bigtreetech/BIGTREETECH-MAX31865/BIGTREETECH MAX31865 V2.0/Hardware/BIGTREETECH MAX31865 V2.0-PIN.pdf

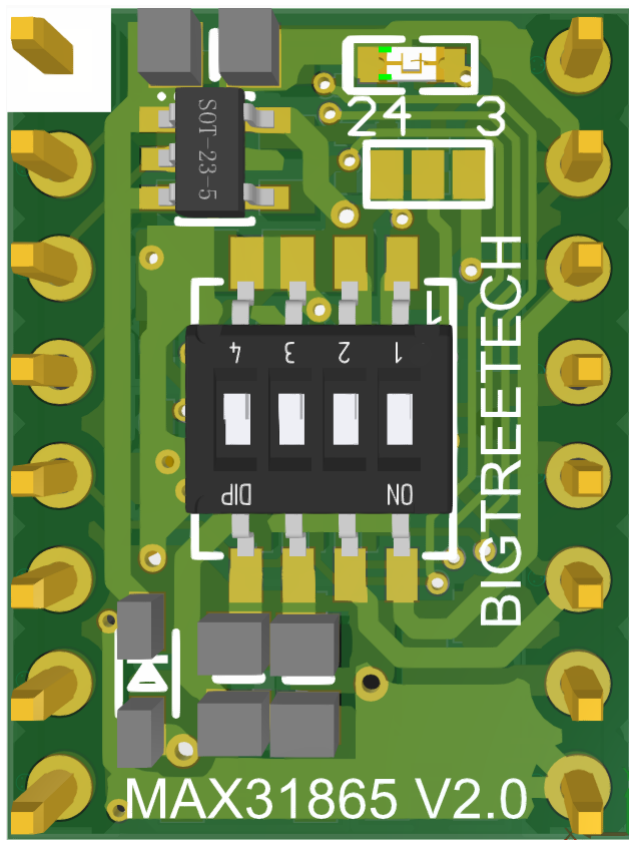
[picture p11: figure]

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
FORCE+

RTDIN+

RTDIN

NC

FORCE

NC

NC
