bigtreetech/BIGTREETECH-MAX31865/BIGTREETECH MAX31865 V1.0/3D/BTT MAX31865 V1.0.step

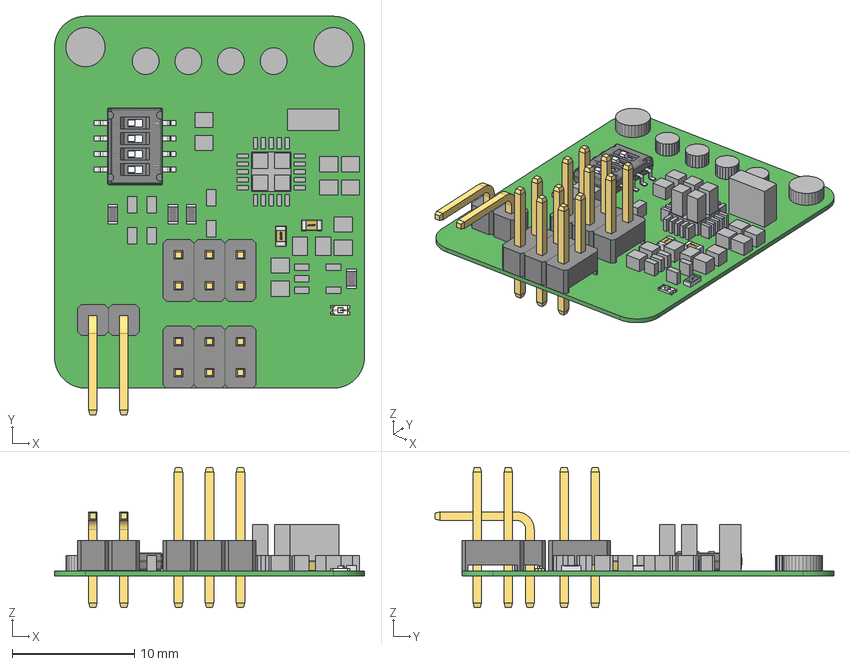
[picture p12: CAD file, 2021-06-21, an earlier design]
BIGTREETECH MAX31865 V1.0/3D/BTT MAX31865 V1.0.step
25.4 x 32.7 x 11.5 mm
R0603 x 4
Open_CASCADE_STEP_translator_6.8_20.1
Open_CASCADE_STEP_translator_6.8_20.2.1
Leader x 8
LOGO? x 9
LED_0603-W
Extruded x 58
HDR2.54-1x2P x 6
HDR2.54-1P_H x 2
