bigtreetech/BIGTREETECH-MAX31865/EZ31865_V1.0/Hardware/BIGTREETECH EZ31865 V1.0 Manual.pdf

BIGTREETECH EZ31865 V1.0 USER MANUAL | Shenzhen Biqu Technology Limited Company
Shenzhen Biqu Technology | 1 / 11 | URL:www.BIGTREE-TECH.com

SHENZHEN BIQU TECHNOLOGY LIMITED COMPANY BIGTREETECH

# BIGTREETECH

# EZ31865 V1.0

# USER MANUAL

【Please read this manual carefully before use】

BIGTREETECH MAX31865 V2.0 USER MANUAL Shenzhen Biqu Technology Limited company

2 / 11

# CONTENTS

BIGTREETECH motherboard and BIGTREETECH EZ31865 V1.0 module connection

3 / 11

## Revision History

Version | Revisions | Date
01.00 | Original | 2022/11/08


4 / 11

# BIGTREETECH MAX31865 V2.0 Module

## Introduction

This module uses MAX31865 chip, supports two-wire, three-wire,

four-wire PT1000 and PT100 temperature sensors, adopts the same

package of motor drive module, easy to install, and uses VCCIO part of

the power supply. Support 3.3V-5V power input.

## 1.Pin Introduction

VIO—Positive power supply (3.3V-5V)

GND—Power negative

MO--data input

MI--Data output

SCK--Clock line

CS--Chip Select


5 / 11

## 2.DIP Switch Configuration

1 | 2 | 3 | 4 | Sensor Model
ON | ON | ON | OFF | Two lines PT100
ON | ON | OFF | ON | Two linesPT1000
OFF | ON | ON | OFF | Three lines PT100
OFF | ON | OFF | ON | Three lines PT1000
OFF | OFF | ON | OFF | Four-wire PT100
OFF | OFF | OFF | ON | Four-wire PT1000

The 2/4 line is shown in the left figure. If the 3 line is used, it needs to be changed to the right figure (the factory default is 2/4 line)

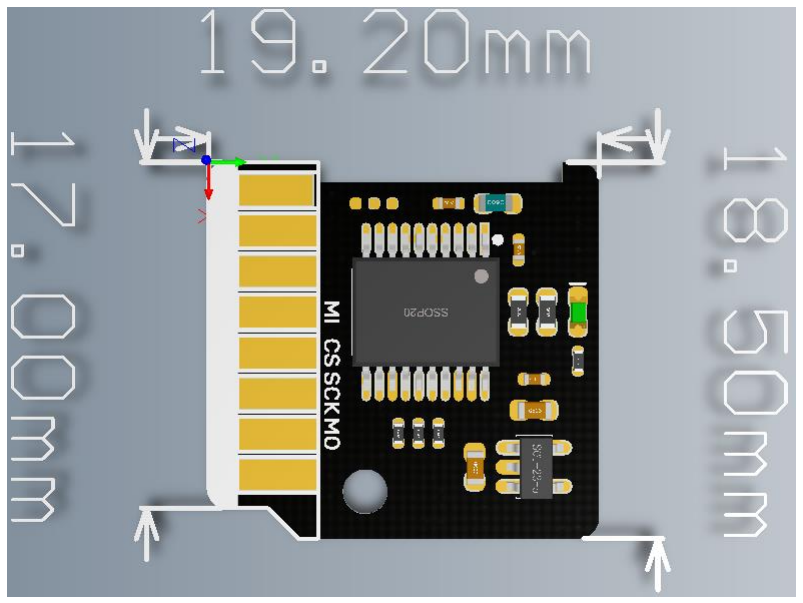
[picture p13: figure]

6 / 11

3 wires can also use 2 wires, but the accuracy is slightly reduced (same as 2 wires).

## 3.Connection of Module Installation Method

The installation method is consistent with EZ series drive
Modify the program of the motherboard, select the SPI mode of the motherboard driver jumper, and directly connect BIGTREETECH MAX31865V2.0 to the idle motor driver of the motherboard, and then connect the PT100/PT1000 thermistor to the corresponding original motor line On the interface (need to pay attention to the line sequence, subject to the actual motherboard, only support the motherboard that supports the SPI mode pluggable drive).

# Installation Size:

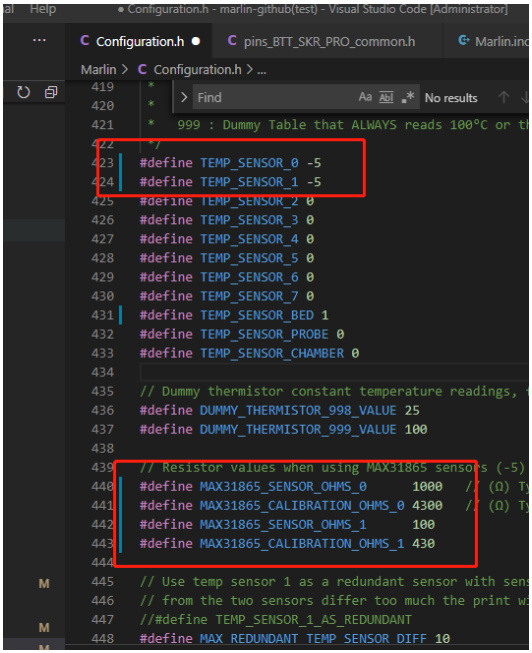
[picture p14: figure]

7 / 11

# Marlin firmware configuration:

Marlin firmware supports the connection of up to two BTT PT1000&PT100 modules. The default is two-wire and four-wire common, through the configuration of Configuration.h and Configuration_adv.h files. The BTT PT1000&PT100 module can be a PT100 or PT1000 sensor, and different parameters need to be configured.

## 1,Configuration in Configuration.h:

TEMP_SENSOR_0 Set to -5: Use MAX31865 module on heater 0 TEMP_SENSOR_1 Set to -5: Use MAX31865 module on heater 1

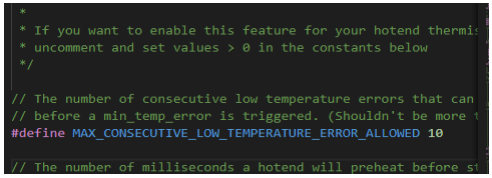
[picture p15: figure]

8 / 11

Currently, only sensors 0 and 1 are configured as MAX31865 modules, others are not supported
If using PT100：
MAX31865_SENSOR_OHMS Set to 100
MAX31865_CALIBRATION_OHMS Set to 430 If using PT1000：
MAX31865_SENSOR_OHMS Set to 1000
MAX31865_CALIBRATION_OHMS Set to 4300
In the picture above： Temperature sensor 0 is configured as a PT1000 MAX31865 module
Temperature sensor 1 is configured as a PT100 MAX31865 module The number of heating rods is 2 (#define EXTRUDERS 2)

## 2,Configuration in Configuration_adv.h：

#define THERMOCOUPLE_MAX_ERRORS | 20

#define MAX_CONSECUTIVE_LOW_TEMPERATURE_ERROR_ALLOWED | 10

#define SHOW_TEMP_ADC_VALUES

#define M115_GEOMETRY_REPORT

## 3,Use BTT-SKR motherboard V1.1 V1.3 V1.4

## BTT-SKR V1.4 turbo

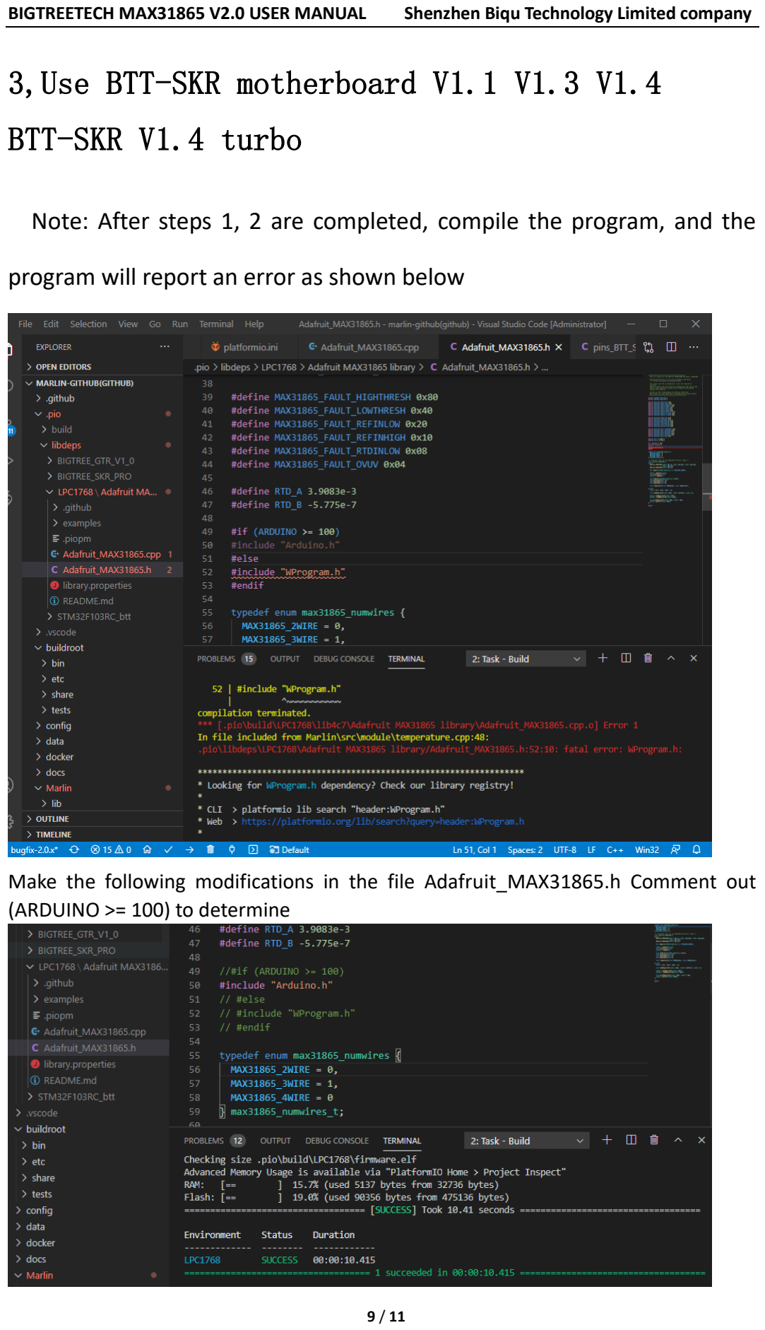
[picture p16: page 9]

9 / 11

Note: After steps 1, 2 are completed, compile the program, and the

program will report an error as shown below

Make the following modifications in the file Adafruit_MAX31865.h Comment out (ARDUINO >= 100) to determine


10 / 11

## BIGTREETECH motherboard and BIGTREETECH EZ31865

## V1.0 module connection configuration:

The following is a tutorial for using the module on the BTT OCTOPUS

V1.0 motherboard (marlin firmware)

1,Use a 4-wire PT1000 sensor and E3 drive interface. Select the SPI mode

of the drive and use BTT EZ Driver Connector V1.0 to connect EZ31865.

2,Add pins in the pin file

#ifndef MAX31865_CS_PIN

#define MAX31865_MISO_PIN | PA6

#define MAX31865_SCK_PIN | PA5

#define MAX31865_MOSI_PIN | PA7

#define MAX6675_SS_PIN | PD3

//#define MAX31865_CS_PIN | PD3
#endif

### At present, to use this module on marlin, you need to define the

MAX31865 chip select as MAX6675_SS_PIN, compile the bin file,

### and you can use it after updating

11 / 11

# Precautions:

Please ensure that the power supply is disconnected when wiring or

dialing the DIP switch

Because this module uses SPI communication, motherboards that do

not support SPI mode pluggable drivers cannot be used directly.
