bigtreetech/BIGTREETECH-MAX31865/(threads)

Thread 2 (2021-08-20):

missing instruction for SKR1.3 and max 31865/ mintemp error

pietja5, 2021-08-20:
MAX31865 is not working with SKR1.3
issue created on Marlin repository
https://github.com/GadgetAngel/MAX31865-SKR-V1-3-GUIDE - is not working

MrMitch17, 2022-07-15:
Yes, Please include Instructions on how to integrate with SKR 1.3.  Thank you.

Thread 4 (2022-06-09):

using Max31865 V2.0 without stepper-slot

trashypopashy, 2022-06-09:
Hi everyone,
has someone connected the MAX31865 module from Bigtreetech to a Printerboard without using a stepper-slot?

rh101, 2022-06-21:
Yes, it would be the same method as connecting V1.0 of the MAX31865 board.  Refer to the [V1.0 manual](https://github.com/bigtreetech/BIGTREETECH-MAX31865/blob/master/BIGTREETECH%20MAX31865%20V1.0/BIGTREETECH%20MAX31865%20V1.0%20Manual.pdf) on how you would do this.

Check page 2 of the [V2.0 manual](https://github.com/bigtreetech/BIGTREETECH-MAX31865/blob/master/BIGTREETECH%20MAX31865%20V2.0/BIGTREETECH%20MAX31865%20V2.0%20Manual.pdf) to get the correct pin-out.  Don't use the `BIGTREETECH MAX31865 V2.0-PIN.pdf` file for the pin-out, because it's not correct (doesn't show VIN etc).

Thread 6 (2023-06-27):

MAX31865 on 2nd extruder on bi se plus idex

Moorey79, 2023-06-27:
G'day, this is pissing me off now.
i want to use a h20 as the second extruder (fair so far)
I also want to retain the ability to use the strain guage for bed leveling. (still fair?)
i accept that only extruder 0+1 can be used with max31865, thats ok, i only have 2 extruders for now.
but here is where i lose my shit.... temp_sensor _1 cant be type -5 (31865) while extruder_0 is type 1.
the 2nd extruder (while built with a strain gouge) doesn't seem able to do abl.
so, i'm screwed, cant have heaps of biqu gear and even slightly believe that it will work together
has anyone else found a way?
