bigtreetech/BIGTREETECH-MAX31865/EZ31865_V1.0/Hardware/BIGTREETECH EZ31865 V1.0-bo.pdf

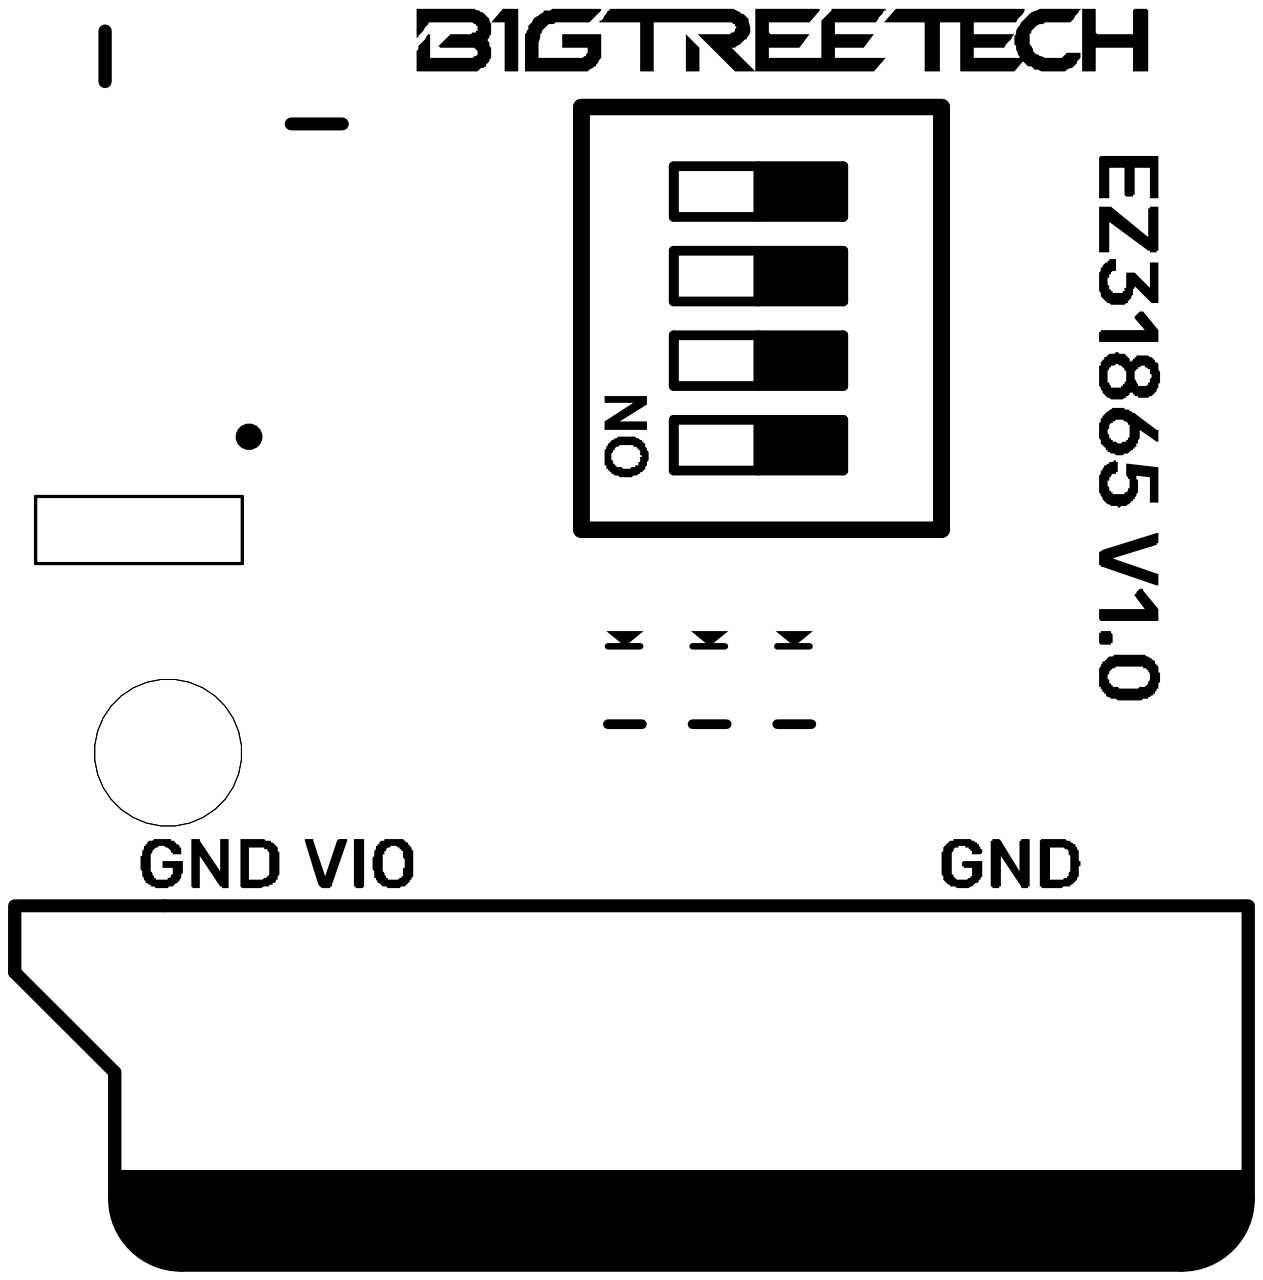
[picture p19: page 1]
