bigtreetech/BIGTREETECH-MAX31865/EZ31865_V1.0/Hardware/BIGTREETECH EZ31865 V1.0-to.pdf

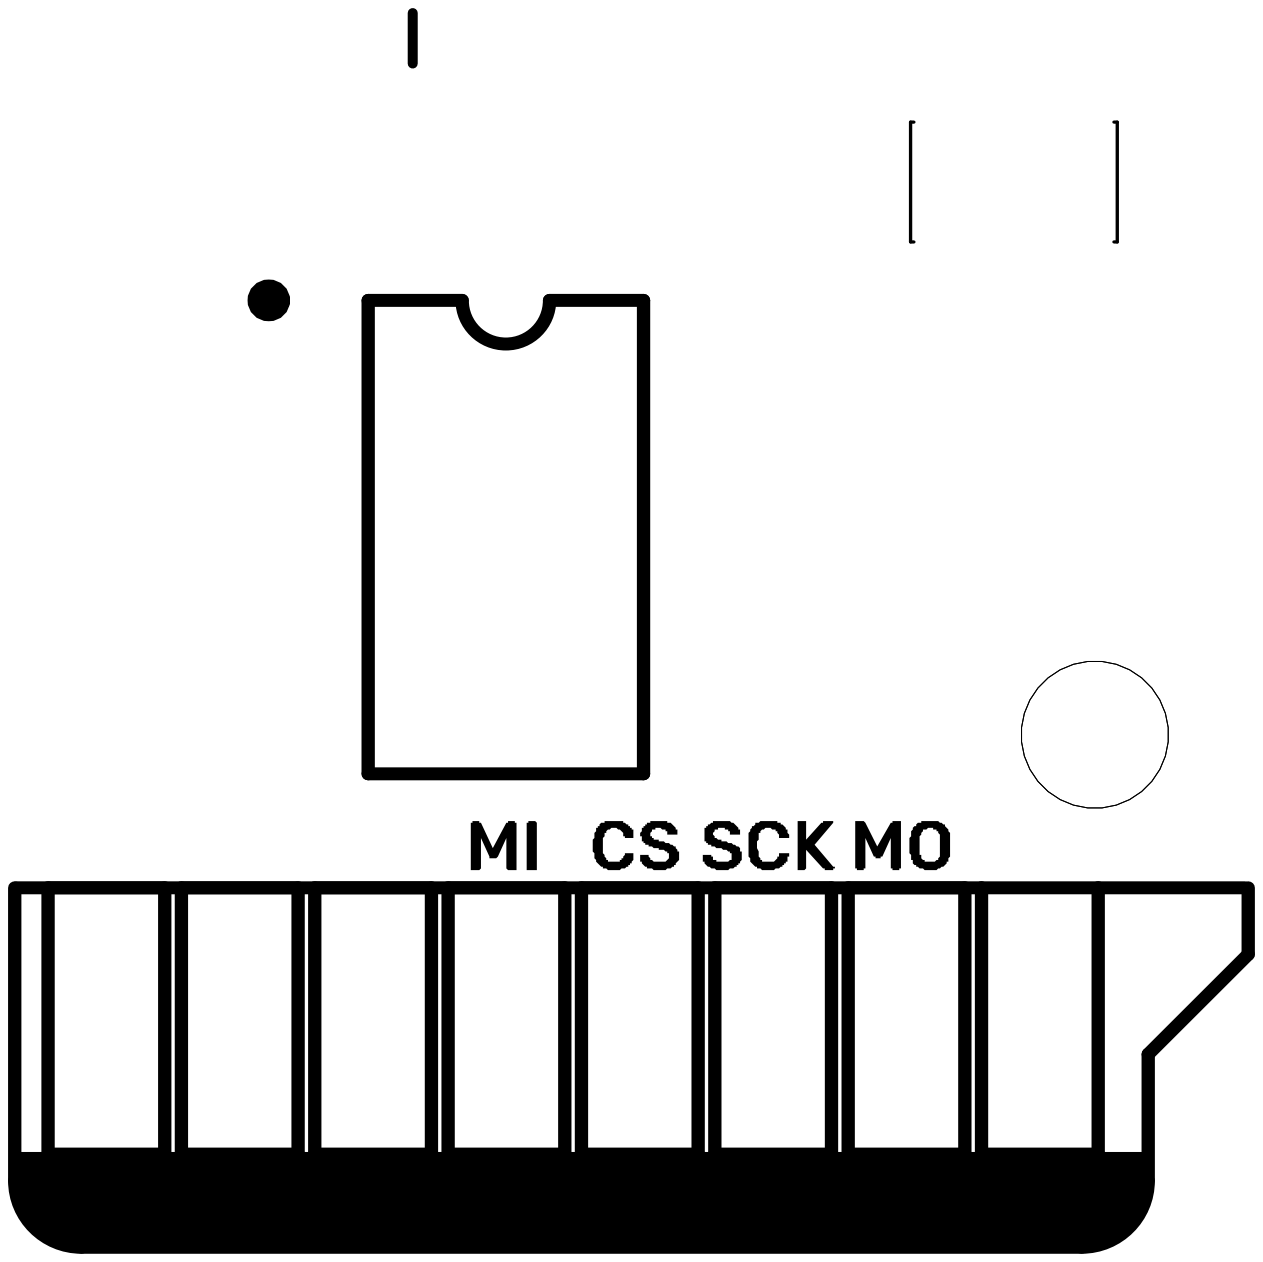
[picture p21: page 1]
