bigtreetech/BIGTREETECH-MAX31865/BIGTREETECH MAX31865 V1.0/Hardware/BIGTREETECH MAX31865 V1.0-PIN.pdf

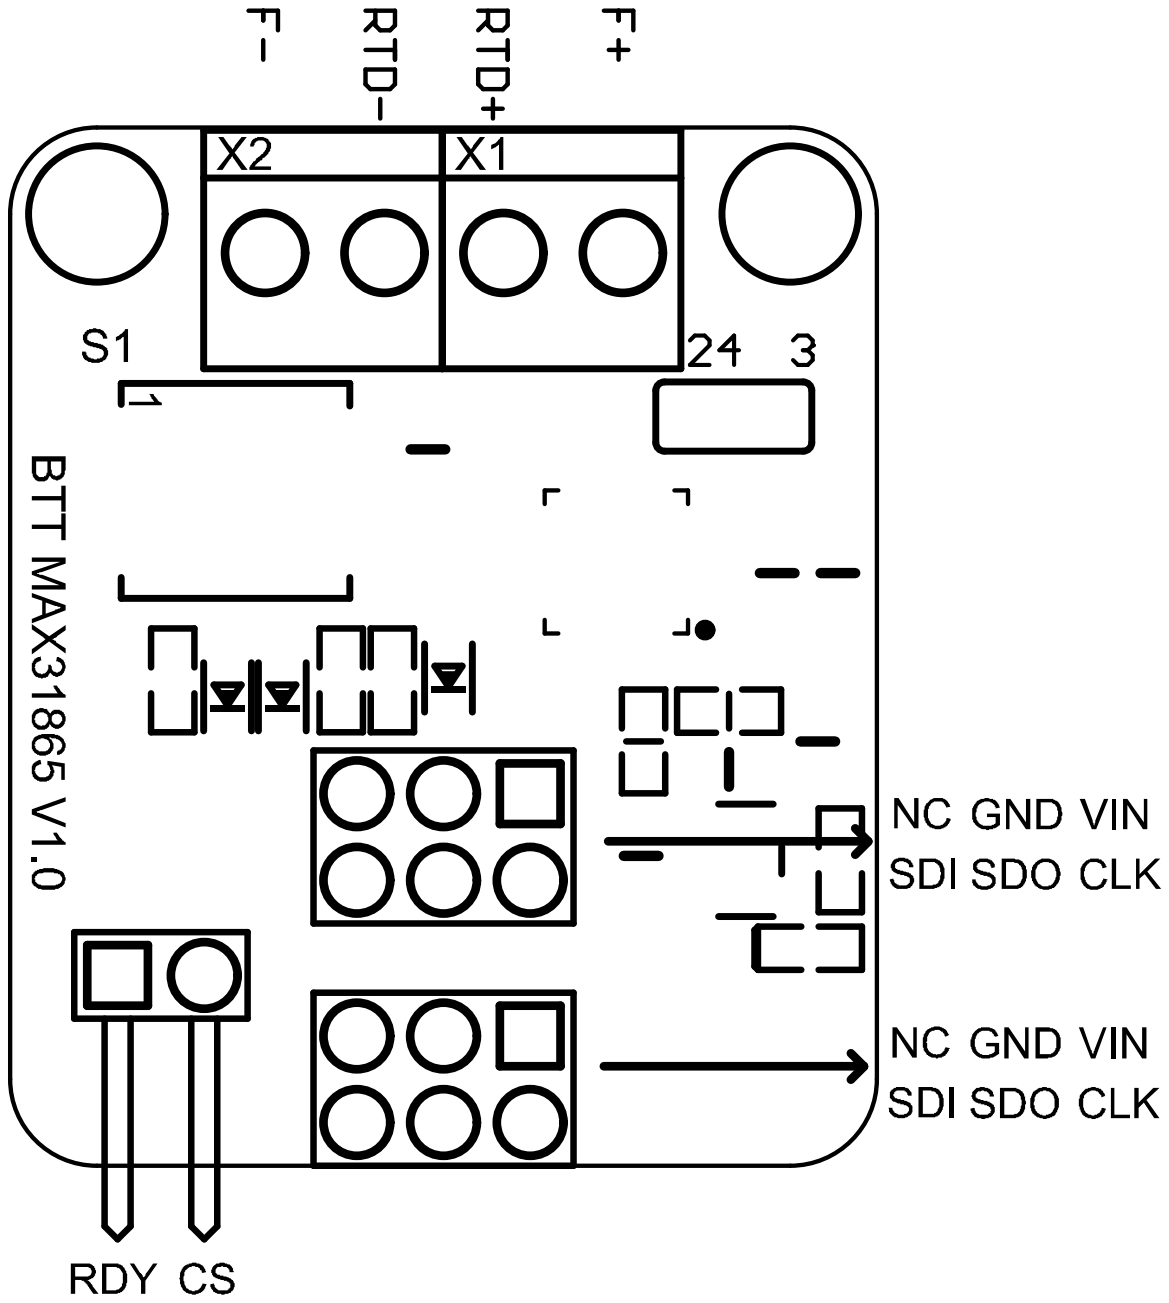
[picture p22: page 1]
