bigtreetech/BIGTREETECH-MAX31865/BIGTREETECH MAX31865 V1.0/Hardware/BIGTREETECH MAX31865 V1.0-SIZE.pdf

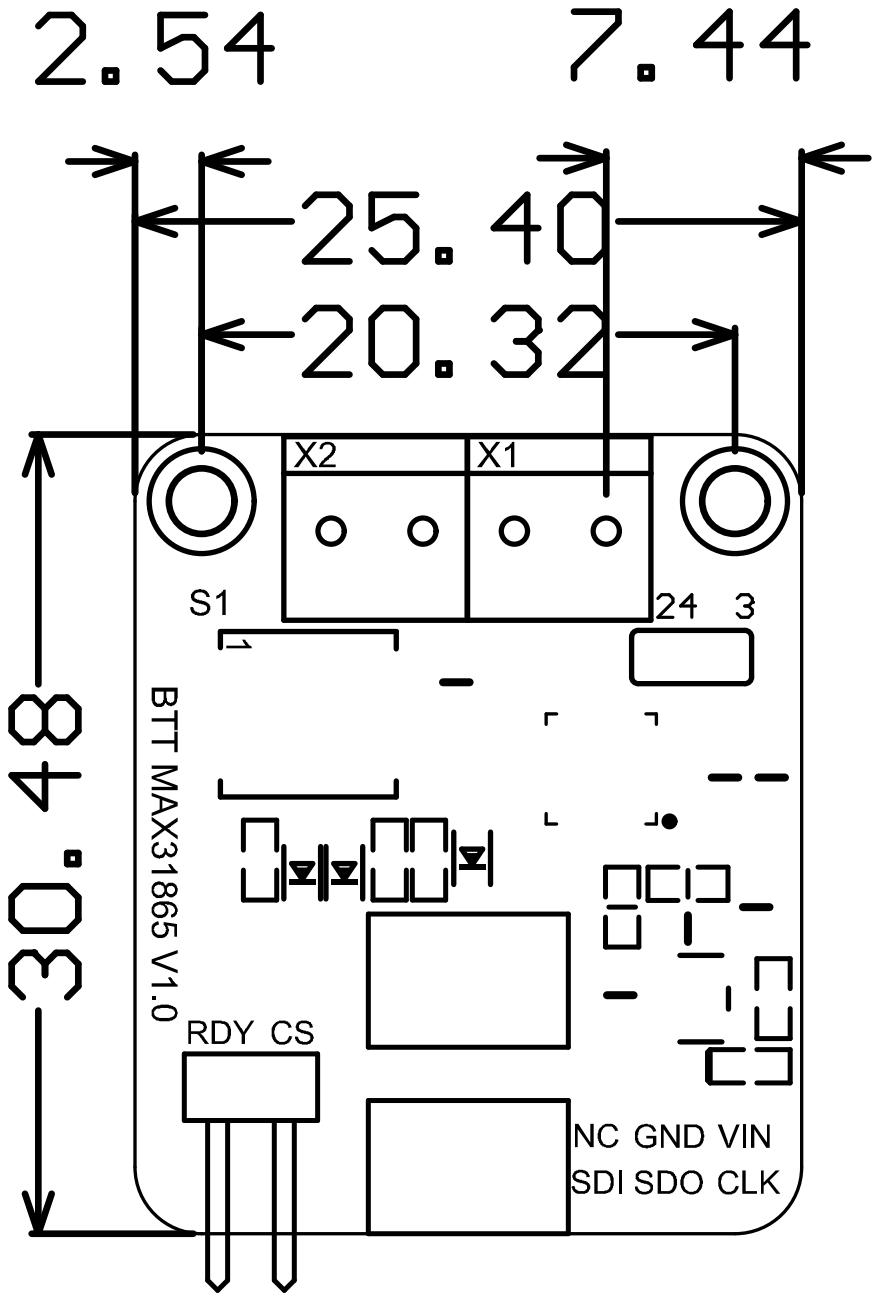
[picture p23: page 1]
