bigtreetech/BIGTREETECH-MAX31865/BIGTREETECH MAX31865 V2.0/Hardware/BTT MAX31865 V2.0-SCH.pdf

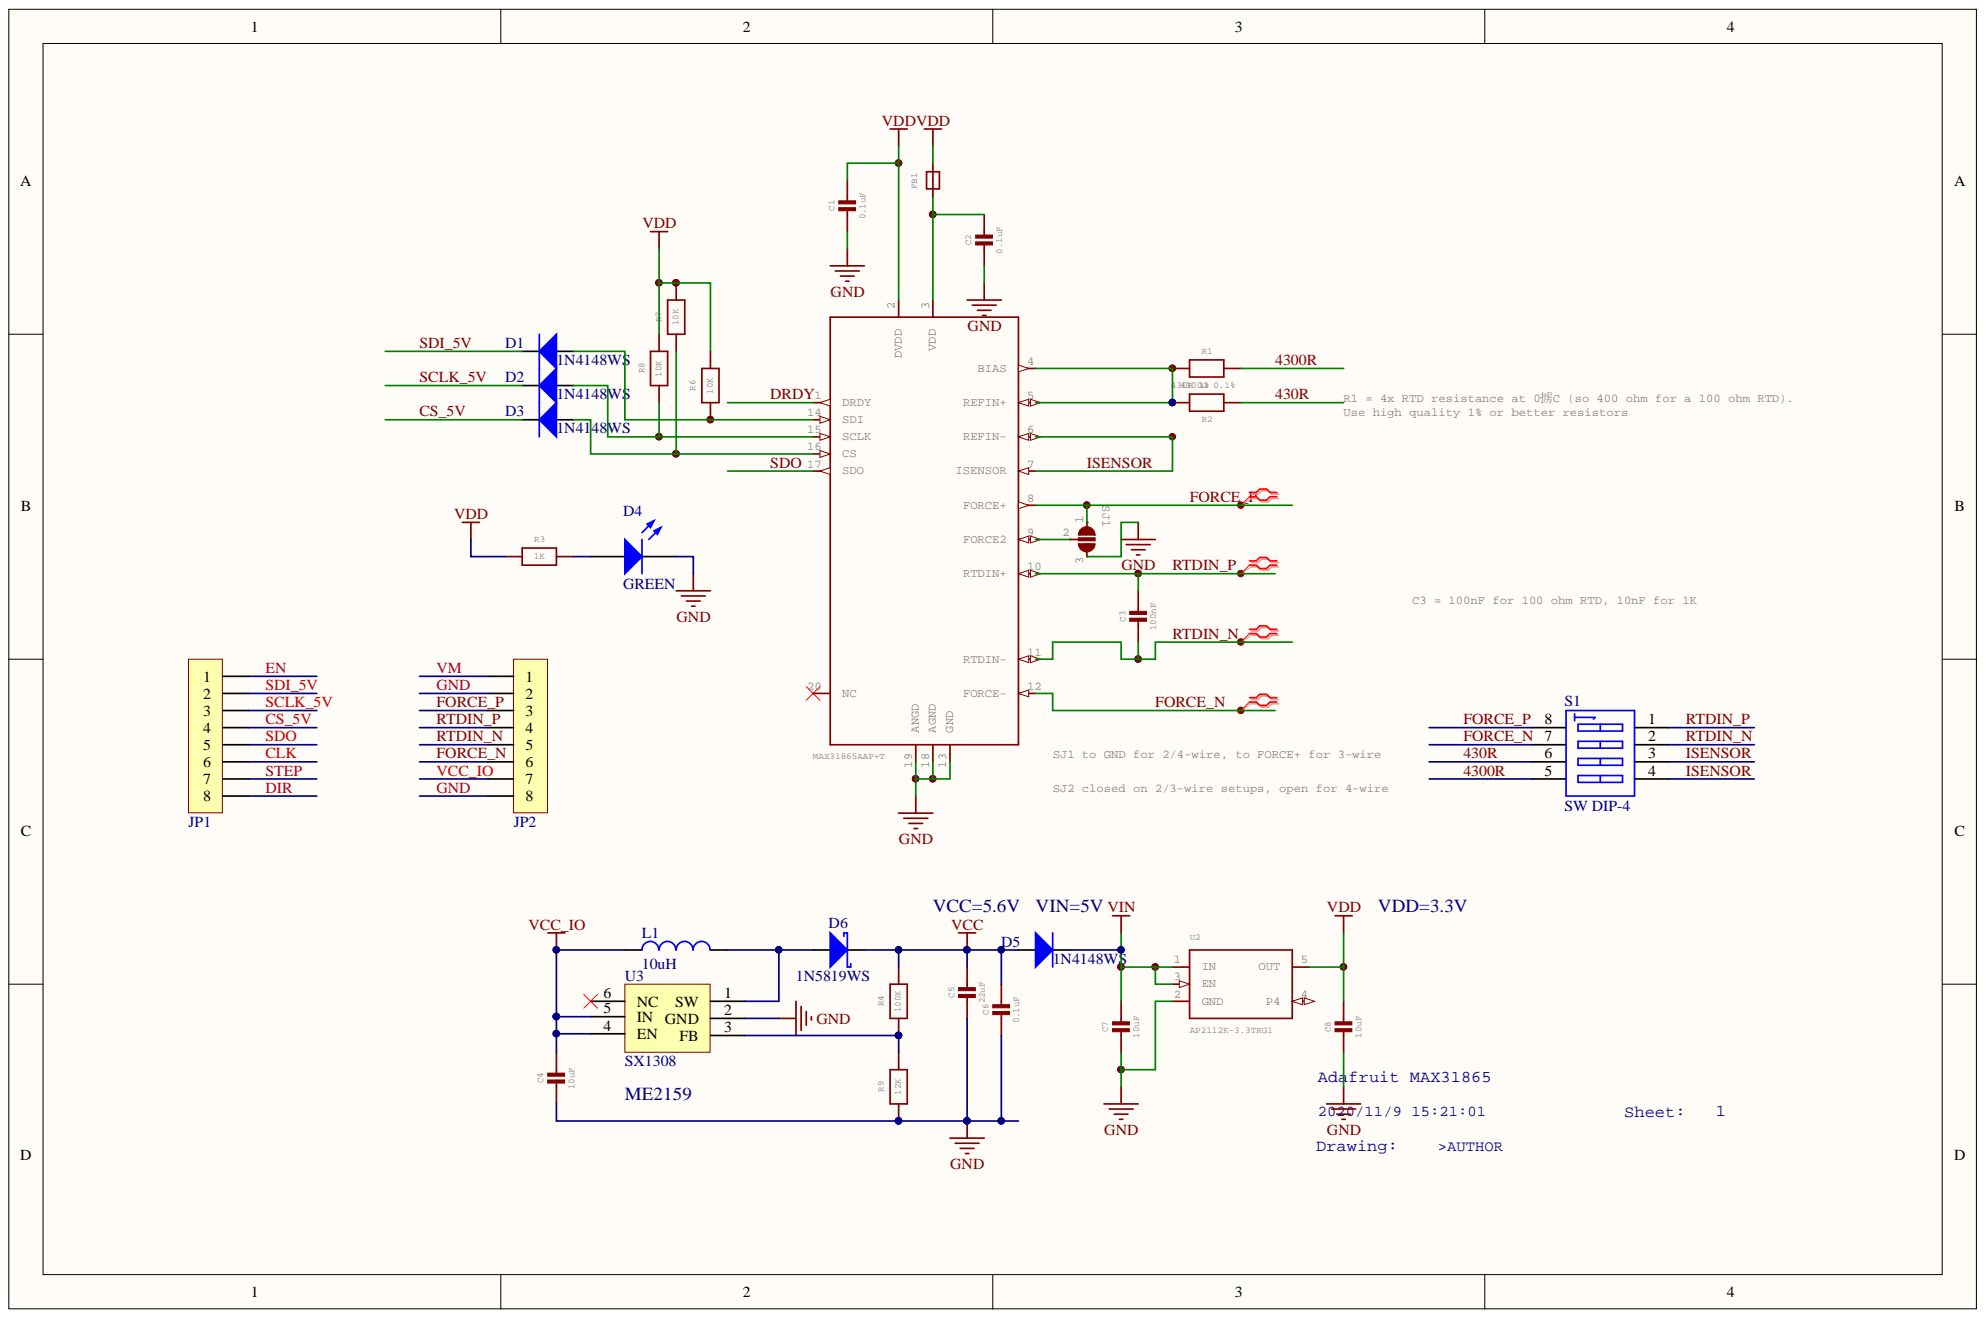
[picture p17: page 1]

R1 = 4x RTD resistance at 0掳C (so 400 ohm for a 100 ohm RTD).
Use high quality 1% or better resistors

C3 = 100nF for 100 ohm RTD, 10nF for 1K

SJ1 to GND for 2/4-wire, to FORCE+ for 3-wire

SJ2 closed on 2/3-wire setups, open for 4-wire
