bigtreetech/BIGTREETECH-MAX31865/BIGTREETECH MAX31865 V2.0/Hardware/BIGTREETECH MAX31865 V2.0-SIZE.pdf

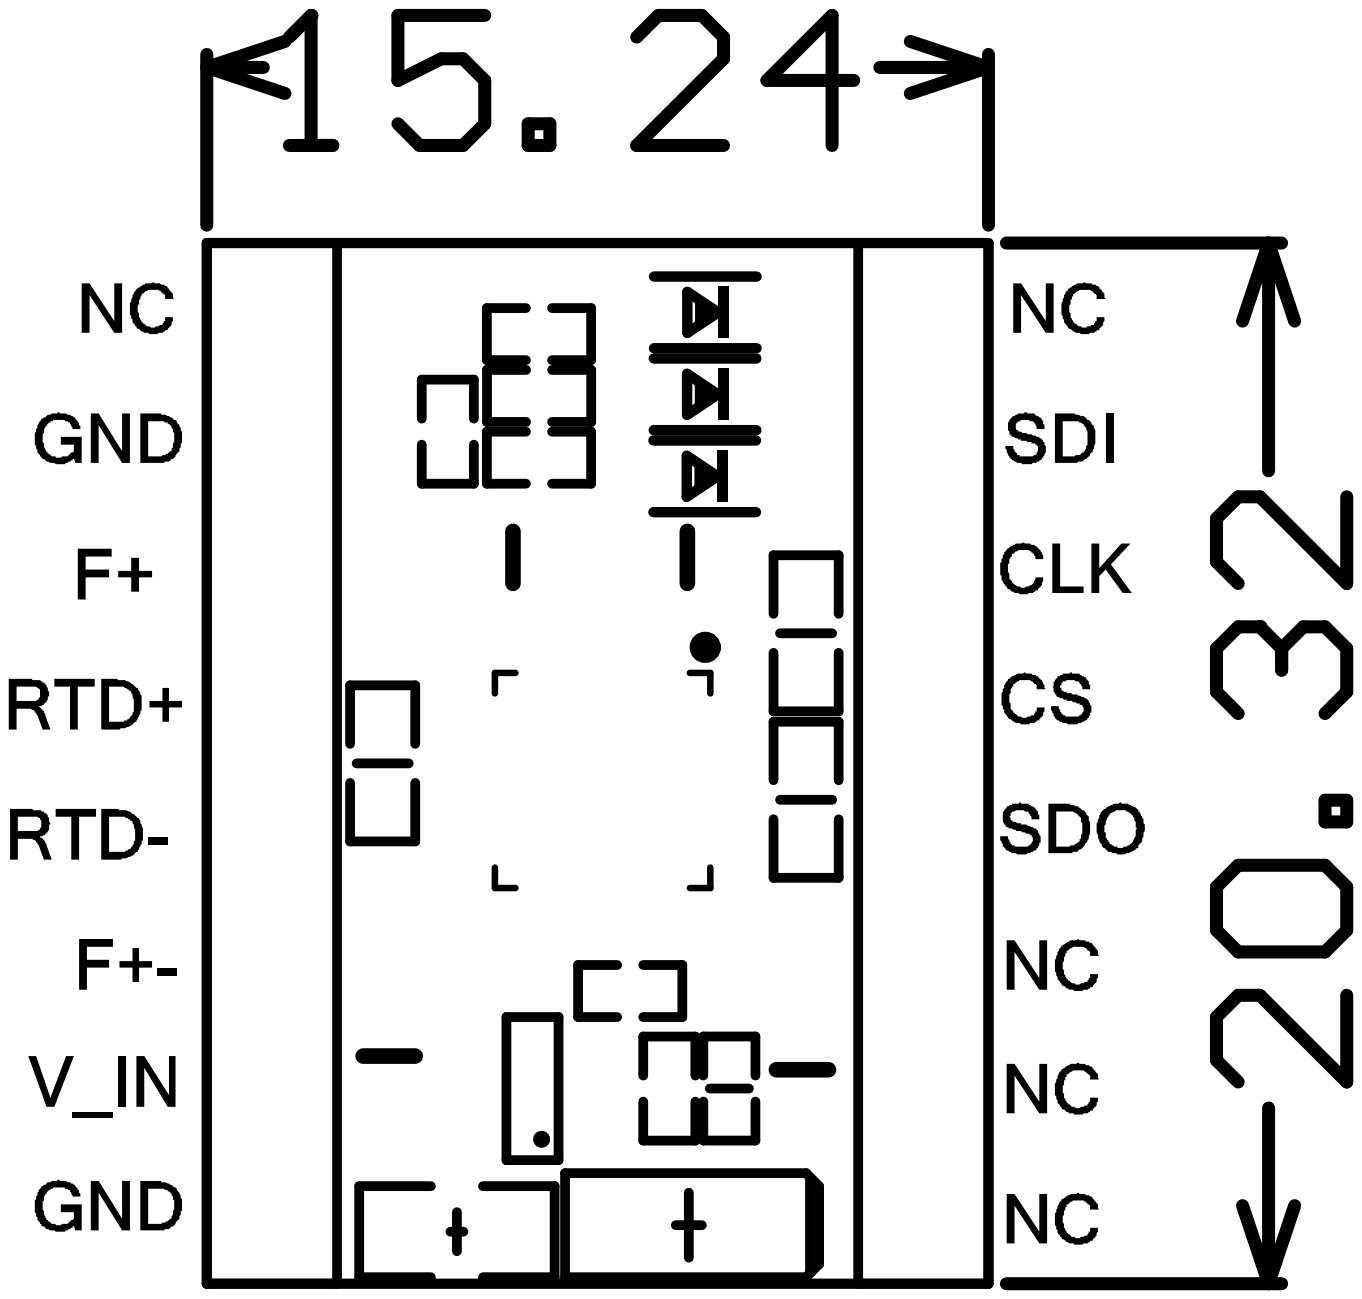
[picture p18: page 1]

Ceramic Capacitors
For new designs, use
the packages
preceded by an '_'
character since they
are more reliable:
The following
footprints should be
used on most
boards: _0402 -
Standard footprint
for regular board
layouts _0603 -
layouts _0805 -
layouts _1206 -
extremely tight-
pitch boards where
space is at a
premium, the
following 'micro-
pitch' footprints can
be used (smaller

100nF | pads, no silkscreen For new designs, use the packages preceded by an '_' character since they are more reliable: The following footprints should be used on most boards: _0402 -Standard footprint for regular board layouts _0603 -Standard footprint for regular board layouts _0805 -Standard footprint for regular board layouts _1206 -Standard footprint for regular board layouts extremely tight-For pitch boards where space is at a premium, the following 'micro-pitch' footprints can be used (smaller Ceramic Capacitors | C3 | Cap_0603 | CAP_CERAMIC0805 -NOOUTLINE | 1

10uF | pads, no silkscreen For new designs, use the packages preceded by an '_' character since they are more reliable: The following footprints should be used on most boards: _0402 -Standard footprint for regular board layouts _0603 -Standard footprint for regular board layouts _0805 -Standard footprint for regular board layouts _1206 -Standard footprint for regular board layouts For extremely tight-pitch boards where space is at a premium, the following 'micro-pitch' footprints can be used (smaller Ceramic Capacitors | C4, C7, C8 | 0805-NO | CAP_CERAMIC0805 -NOOUTLINE | 3

22uF | pads, no silkscreen For new designs, use the packages preceded by an '_' character since they are more reliable: The following footprints should be used on most boards: _0402 -Standard footprint for regular board layouts _0603 -Standard footprint for regular board layouts _0805 -Standard footprint for regular board layouts _1206 -Standard footprint for regular board layouts extremely tight-pitch boards where For space is at a premium, the following 'micro-pitch' footprints can be used (smaller Ceramic Capacitors | C5 | 0805-NO | CAP_CERAMIC0805 -NOOUTLINE | 1

0.1uF | pads, no silkscreen For new designs, use the packages preceded by an '_' character since they are more reliable: The following footprints should be used on most boards: _0402 -Standard footprint for regular board layouts _0603 -Standard footprint for regular board layouts _0805 -Standard footprint for regular board layouts _1206 -Standard footprint for regular board layouts extremely tight-For pitch boards where space is at a premium, the following 'micro-pitch' footprints can be used (smaller Diode SMA | C6 | Cap_0402 | CAP_CERAMIC0805 -NOOUTLINE | 1

1N4148 | pads, no silkscreen Model Volts Amps Type Vf Ir Digikey # Notes SSA34-E3 40V 3A Schottky 480mV @ 3A 200uA @ 40V SSA34-E3/61TGITR-ND CDBA120-G 20V 1A Schottky 500mV @ 1A 500uA @ 20V 641-1014-6-ND REEL MBRA210 10V 2A Schottky 350mV @ 2A 700uA @ 10V MBRA210LT3 SOD-123 Volts Amps Type Model Vf Notes BAT54T1G Ir Order # 30V 200mA Schottky 800mV @ 200mA 2uA @ 25V BAT54T1GOSTR-ND B0530W 30V 500mA Schottky 430mV @ 500mA | D1, D2, D3, D5 | SOD-323 | DIODESOD-323 | 4

GREEN | 130uA @ 30V Typical INFRARED GaAs LED | D4 | LED_0603 | LED0 | 1

DSS14 | Ferrite Bead 0603 MMZ1608B121C -120 Ohm @ 100MHz, 600mA, 0.15 Ohm DC Resistance - Digikey: 445-2164-1-ND BK1608HW121-T -120 Ohm, 600mA Ferrite Chip -Digikey: 587-1876-2-ND HZ0805B272R-10 -0805 2.7K Ohm @ 100MHz, 200mA, 0.8 Ohm DC Resistance - Digikey: 240-2504-1-ND (see also Murata BLM21BD272SN1L) MMZ2012Y152B -1.5K Ohm @ 100MHz, 500mA, 0.4 Ohm DC Resistance - Digikey: 445-1560-1-ND -Mainly for high frequency (80-400MHz) | D6 FB1 | Diode_1206_SOD12 3 0805-NO | ZP_Diode FERRITE-0805NO | 1 1

10uH HDR-1X8 4300Ω 0.1% | Resistors For new MMZ2012R102A -8P接插件 designs, use the packages preceded by an '_' character since they are more reliable: The following footprints should be used on most boards: _0402 - Standard footprint for regular board layouts _0603 -Standard footprint for regular board layouts _0805 -Standard footprint for regular board layouts _1206 -Standard footprint for regular board layouts For extremely tight-pitch boards where space is at a premium, the following 'micro-pitch' footprints can be used (smaller pads, no silkscreen Resistors For new | JP1, JP2 L1 R1 | L_0805 HDR-1X8 0805-NO | Inductor Header 8 RESISTOR0805_NO OUTLINE | 1 2 1

430R 1% | outline, etc.): designs, use the packages preceded by an '_' character since they are more reliable: The following footprints should be used on most boards: _0402 - Standard footprint for regular board layouts _0603 -Standard footprint for regular board layouts _0805 -Standard footprint for regular board layouts _1206 -Standard footprint for regular board layouts For extremely tight-pitch boards where space is at a premium, the following 'micro-pitch' footprints can be used (smaller pads, no silkscreen Resistors For new | R2 | 0805-NO | RESISTOR0805_NO OUTLINE | 1

1K | outline, etc.): designs, use the packages preceded by an '_' character since they are more reliable: The following footprints should be used on most boards: _0402 - Standard footprint for regular board layouts _0603 -Standard footprint for regular board layouts _0805 -Standard footprint for regular board layouts _1206 -Standard footprint for regular board layouts extremely tight-For pitch boards where space is at a premium, the following 'micro-pitch' footprints can be used (smaller pads, no silkscreen Resistors For new | R3 | Res_0402 | RESISTOR0805_NO OUTLINE | 1

100K | outline, etc.): designs, use the packages preceded by an '_' character since they are more reliable: The following footprints should be used on most boards: _0402 - Standard footprint for regular board layouts _0603 -Standard footprint for regular board layouts _0805 -Standard footprint for regular board layouts _1206 -Standard footprint for regular board layouts For extremely tight-pitch boards where space is at a premium, the following 'micro-pitch' footprints can be used (smaller pads, no silkscreen | R4 | Res_0402 | RESISTOR0805_NO OUTLINE | 1

10K | outline, etc.): Resistors For new designs, use the packages preceded by an '_' character since they are more reliable: The following footprints should be used on most boards: _0402 - Standard footprint for regular board layouts _0603 -Standard footprint for regular board layouts _0805 -Standard footprint for regular board layouts _1206 -Standard footprint for regular board layouts For extremely tight-pitch boards where space is at a premium, the following 'micro-pitch' footprints can be used (smaller pads, no silkscreen | R6, R7, R8 | Res_0402 | RESISTOR0805_NO OUTLINE | 3

12K | outline, etc.): Resistors For new designs, use the packages preceded by an '_' character since they are more reliable: The following footprints should be used on most boards: _0402 - Standard footprint for regular board layouts _0603 -Standard footprint for regular board layouts _0805 -Standard footprint for regular board layouts _1206 -Standard footprint for regular board layouts extremely tight-For pitch boards where space is at a premium, the following 'micro-pitch' footprints can be used (smaller pads, no silkscreen | R9 | Res_0402 | RESISTOR0805_NO OUTLINE | 1

SW DIP-4 | outline, etc.): DIP Switch, 4 Position, SPST | S1 | DHN-04F | SW DIP-4 | 1

Jumper 2-Way Solder | SJ1 | 3-2 | SOLDERJUMPER_2W AY | 1

MAX31865 | MAX31865 -Resistance to Digital Convertor for Platinum Resistance Temperature Detectors (RTDs) Handles 100 ohm -1K ohm (at 0掳C) platinum RTDs. 15-bit ADC resolution (nominally 0.03125 掳C), 0.5掳C accuracy. | U1 | QFN20_4MM_0.65M M | TEMP_MAX31865 | 1

AP2112K-3.3TRG1 | SOT23-5 Fixed Voltage Regulators PartCurrent OutV OutV InV Dropout胃 JA (掳C/W)TJ (掳 C)Digikey Part No. ADP121 150mA 3.3V 3.4-5.5V 0.09V @ 150mA ----AUJZ33R7CT-ND ADP121-ADP121 150mA 3.0V 3.1-5.5V 0.09V @ 150mA ----AUJZ30R7CT-ND ADP121-ADP122 300mA 3.3V 3.4-5.5V 0.085V @ 300mA - -- ADP122AUJZ-3.3-R7CT-ND ADP1712 300mA 3.3V 3.5-5.5V 0.17V @ 300mA ----ADP1712AUJZ-3.3-R7TR-ND AP7311 (Low Cost) 150mA 3.3V 3.5-6V 0.15V @ 150mA | U2 - | SOT-23-5 | VREG_SOT23-5 | 1

SX1308 | ---- AP7311- | U3 | SX1308_SOT23 | SX1308_SOT23 | 1
